opennukit/Nukit-Open-Air-Purifier/Nukit Open Air Purifier-H(anging) v1.0/README.md

**Nukit Open Air Purifier-H(anging) v1.0**
---
This unit is designed to be suspended from the ceiling.

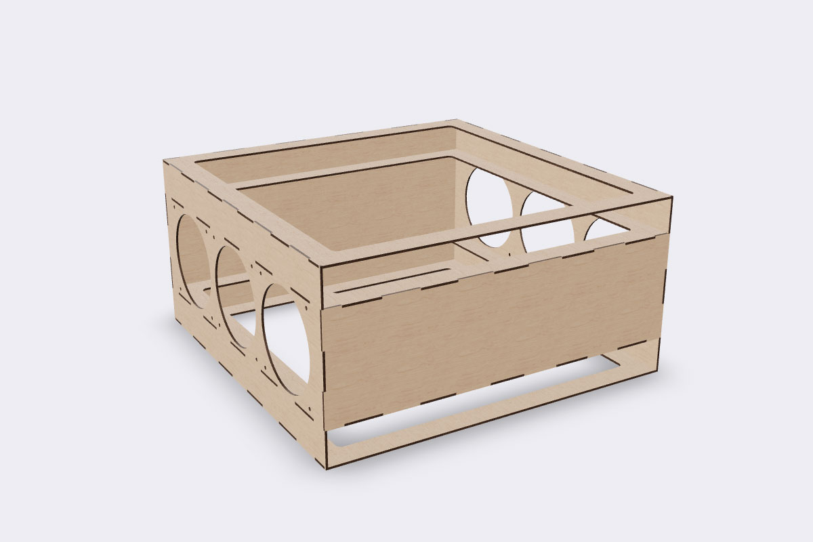
[picture p2: Nukit Open Air Purifier-H(anging) v1.0/Nukit Open Air Purifier-H v1.0.jpg]
Nukit Open Air Purifier-W(all) v1.0


To hang your Nukit Open Air Purifier, [use these](https://www.amazon.com/D-Ring-ExcelFu-Anchor-Lashing-Trailers/dp/B07RVHZSP9) with M4 bolts through the fan mounting holes and fans, using locknuts to secure them at all four corners:

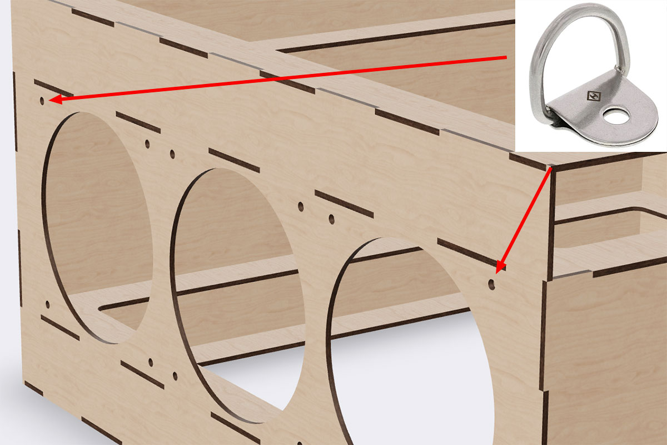
[picture p3: Nukit Open Air Purifier-H(anging) v1.0/Nukit-Open-Air-Purifier-H-v1.0-Pad-Eye.jpg]
Nukit Open Air Purifier-W(all) v1.0 how to hang


Suspend with lightweight chain or swaged steel cable- NOT string or rope as slight motion from the unit may eventually cause them to fail. 

Note: These were designed and offered due to repeated requests but with some reluctance. This is because they may not comply with local fire codes. Be sure to ask your fire marshal before deploying them. While they (or any 12v air purifier) are an unlikely ignition source, they are effectively a suspended, difficult-to-access fuel source. If they are mounted higher than 3 meters, it may not be possible to reach them with a conventional fire extinguisher. Something [like this](https://www.amazon.com/Ougist-Automatic-Extinguisher-Effectively-Extinguishes/dp/B0BY4PCCTN) could be secured inside, but wall-mounted units, installed out of easy reach, would be significantly safer.
