opennukit/Nukit-Open-Air-Purifier/Nukit Open Air Purifier-T(ower) v1.0/README.md

**Nukit Open Air Purifier-T(ower) v1.0**
---
This is the most traditionally shaped model designed to sit on the floor or a table. Make sure to use appropriate fan guards if there will be children near it.

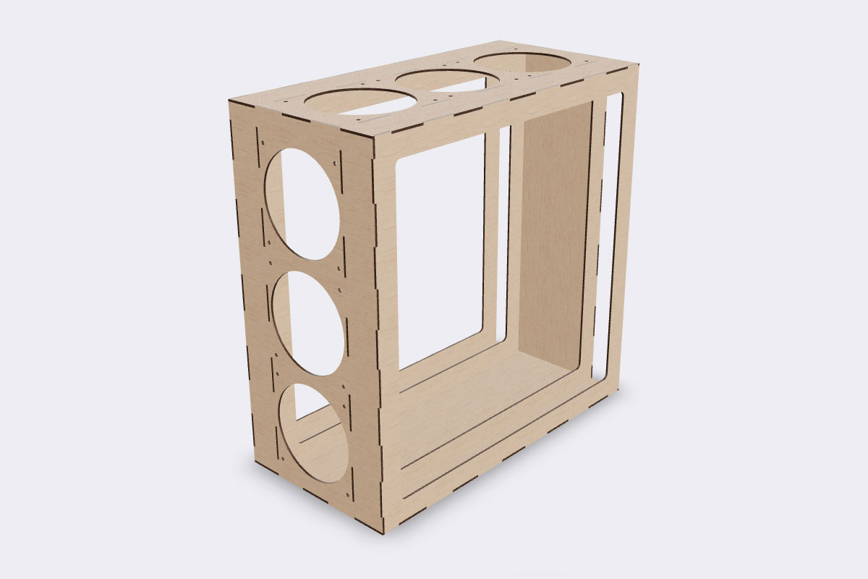
[picture p4: Nukit Open Air Purifier-T(ower) v1.0/Nukit Open Air Purifier-T v1.0.jpg]
Nukit Open Air Purifier-T(ower) v1.0
