opennukit/Nukit-Open-Air-Purifier/Nukit Open Air Purifier-W(all) v1.0/Nukit Open Air Purifier-W v1.0.jpg

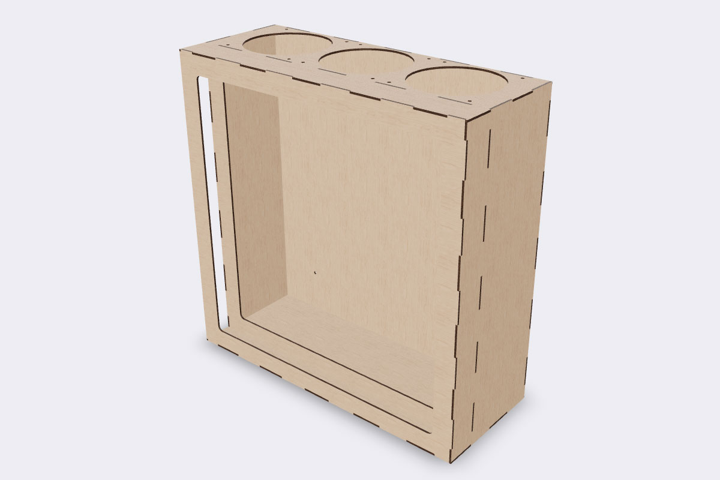
Nukit Open Air Purifier-W(all) v1.0/Nukit Open Air Purifier-W v1.0.jpg
