opennukit/Nukit-Open-Air-Purifier/Nukit Open Air Purifier-H(anging) v1.0/Nukit Open Air Purifier-H v1.1 Split.dxf

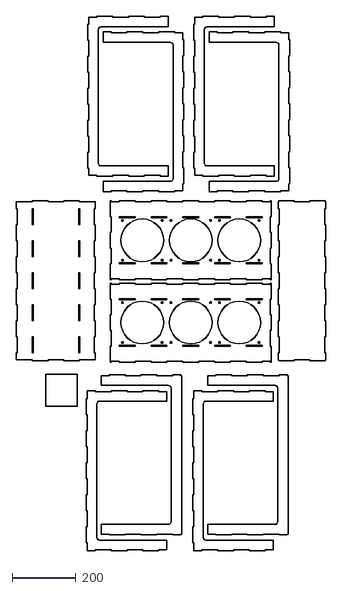
[picture p6: CAD file, 2024-01-09]
Nukit Open Air Purifier-H(anging) v1.0/Nukit Open Air Purifier-H v1.1 Split.dxf
969.6 x 1675.3
