opennukit/Nukit-Open-Air-Purifier/Nukit Open Air Purifier-T(ower) v1.0/Nukit Open Air Purifier-T v1.1.dxf

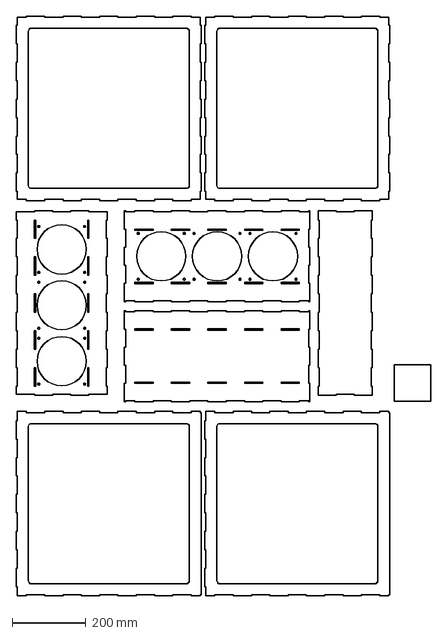
[picture p7: CAD file, 2024-01-09]
Nukit Open Air Purifier-T(ower) v1.0/Nukit Open Air Purifier-T v1.1.dxf
1128.3 x 1577.6 mm
