opennukit/Nukit-Open-Air-Purifier/Nukit Open Air Purifier-W(all) v1.0/Nukit Open Air Purifier-W v1.1 Split.dxf

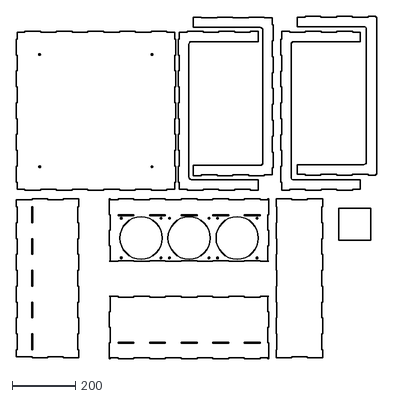
[picture p8: CAD file, 2024-01-09]
Nukit Open Air Purifier-W(all) v1.0/Nukit Open Air Purifier-W v1.1 Split.dxf
1140.1 x 1082.8
