opennukit/Nukit-Open-Air-Purifier/Nukit Open Air Purifier-H(anging) v1.0/Nukit Open Air Purifier-H v1.1.dxf

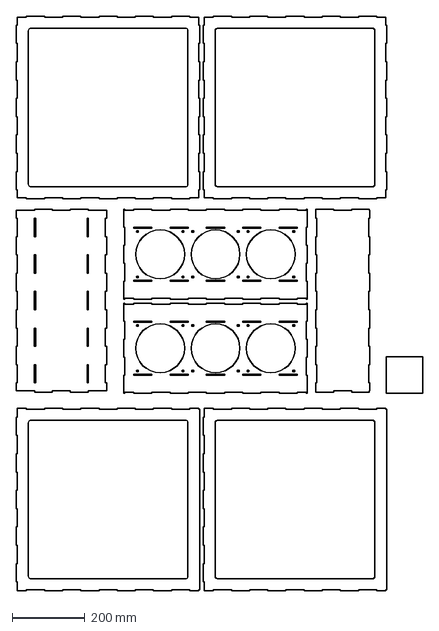
[picture p9: CAD file, 2024-01-09]
Nukit Open Air Purifier-H(anging) v1.0/Nukit Open Air Purifier-H v1.1.dxf
1115.3 x 1577.6 mm
