opennukit/Nukit-Open-Air-Purifier/Nukit Open Air Purifier-T(ower) v1.0/Nukit Open Air Purifier-T v1.1 Split.dxf

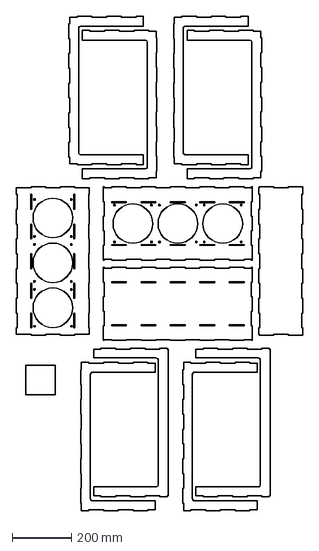
[picture p10: CAD file, 2024-01-09]
Nukit Open Air Purifier-T(ower) v1.0/Nukit Open Air Purifier-T v1.1 Split.dxf
969.6 x 1673.0 mm
