opennukit/Nukit-Open-Air-Purifier/Nukit Open Air Purifier-W(all) v1.0/Nukit Open Air Purifier-W v1.1.dxf

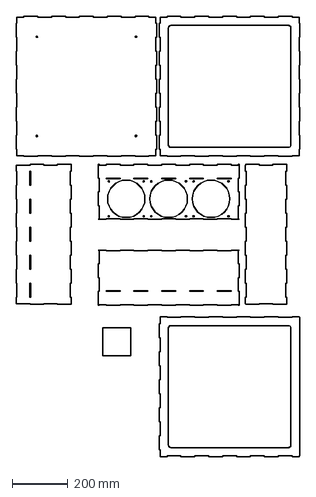
[picture p11: CAD file, 2024-01-09]
Nukit Open Air Purifier-W(all) v1.0/Nukit Open Air Purifier-W v1.1.dxf
1016.9 x 1577.6 mm
