opennukit/Nukit-Open-Air-Purifier/(threads)

Thread 3 (2024-02-11):

box-fan filters

tomByrer, 2024-02-11:
You could get more filtering cheaper with fans & filters available at any big hardware or general (eg Wal*Mart) store:
https://cleanaircrew.org/box-fan-filters/

I used the single filter version in my home; worked fine for only 5-10 minutes of 'building'.  Another video said it was 85% as effective as commercial air filters.

TheCloudCrafter, 2024-02-22:
Nice call out. Great reference video.

I'm looking at this project and trying to adapt it to take 200mm fans instead of 140mm fans for better airflow and lower noise.
Still doing research and tinkering with a proof of concept. I'm thinking of doing 10x20 or 10x10 filters instead of the 20x20 as well. Concerned about total CFM and fans needed.

The site you linked has a nice breakdown of using box fans with the needed math. Fun stuff!!

Thread 4 (2024-06-28):

Wiring hints?

geeksam, 2024-06-28:
Very cool project.  I don't have access to a laser cutter, but I do have a table saw, and I'd love to build something like this for dust management in my workshop—and It'll be good practice for when my commercial air purifiers eventually fail.

Also appreciate the README.  Having links to parts is super helpful.  And, I love that the README doesn't assume that the reader knows enough about woodworking to be confident doing a glue-up—or even that they have clamps.  :)

That said, I could use an equivalent level of remedial hints when it comes to the electronics.  I have super basic questions, like:  how many fans can run on a single power adapter?  Assuming the answer to that is more than "one", are there connectors to chain them, or do I bust out electrical tape and wire the fans together directly?

👶😂  _(I did build a few PCs for work once, but it was... 1997, I think, and I just bought what the nice people in the computer store picked out for me.  Even if I remembered any of that, I'm sure it'd be obsolete now.)_

billxsand, 2024-09-23:
If you click to the 4th picture on the amazon page for the fans, [LINK](https://www.amazon.com/gp/product/B07HCKWF2X), it shows the daisy chain feature on these fans. 0 wiring experience required to just daisy chain them, out of the box

The 12v unit linked should also be fine for such a load, I'm building this very soon and I'll update if I have any issues with the linked power supply

Thread 5 (2024-08-09):

Detailed assembly instructions?

billxsand, 2024-08-09:
Am I missing the detailed instructions? I'm just kind of matching the pieces to the photo. I was wondering if there is anything more detailed. Something Lego-like ?

billxsand, 2024-09-09:
Work In Progress instructions here:

https://docs.google.com/document/d/1IkrJM0XvA3xa3t18xnbdpEnlCruTwF5EAfmtK07XZO8/edit?usp=sharing
